SeeedDocument/RePhone_core_2G-Atmel32u4/img/New Microsoft PowerPoint 演示文稿.pptx

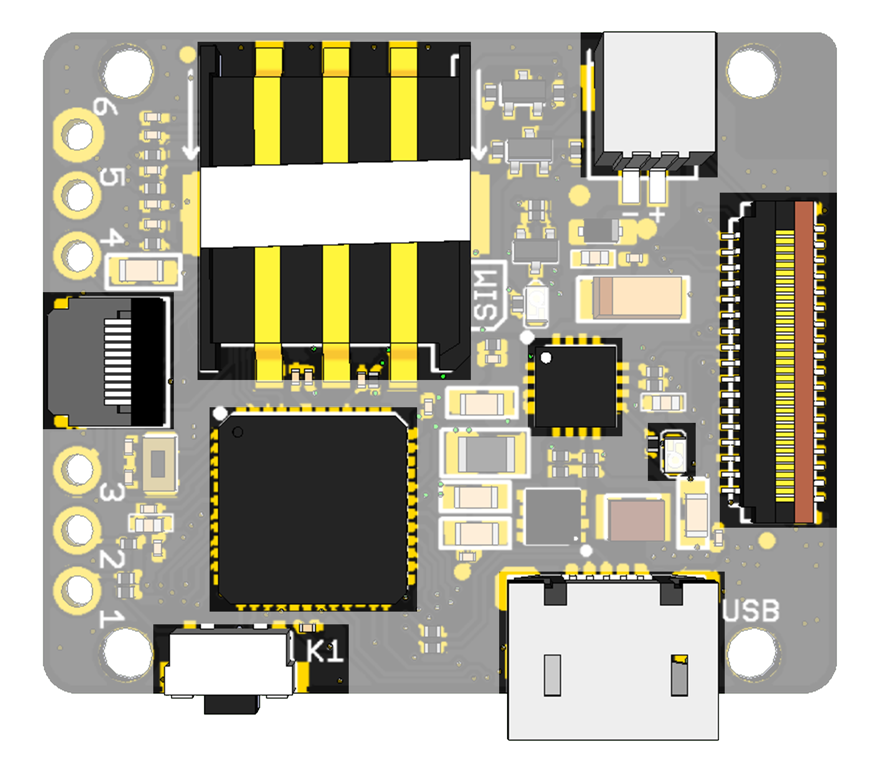
[picture p4: figure]

TOP

5

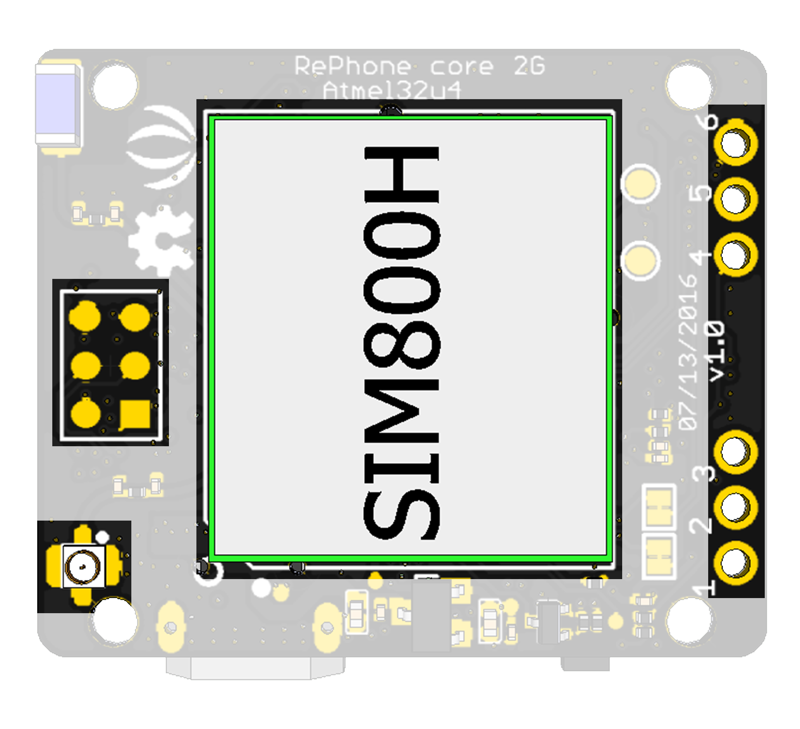
[picture p5: figure]

BOTTOM

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
## Slide 2

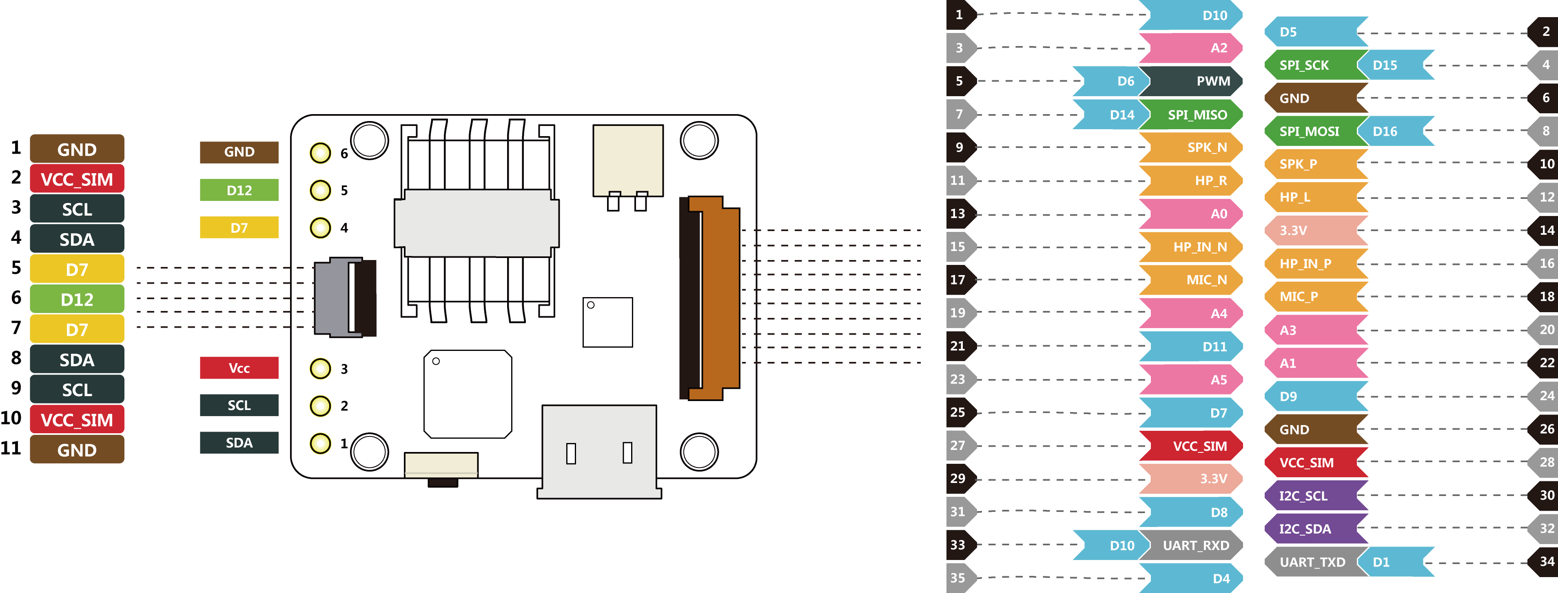
[picture p6: figure]

## Slide 3

Download AT Command
