SeeedDocument/RePhone_core_2G-Atmel32u4/img/arduino_ide.png

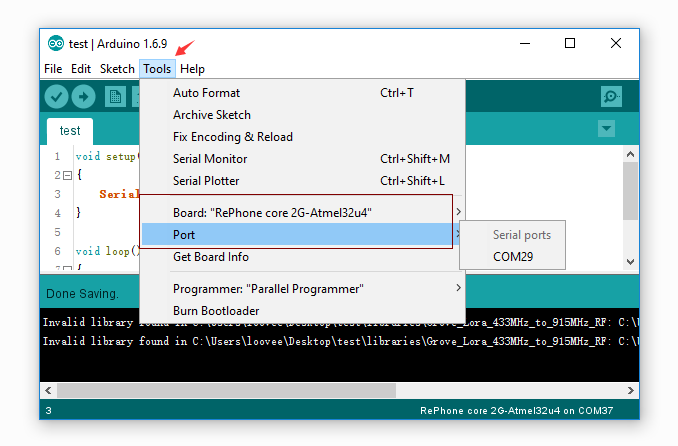
img/arduino_ide.png
