SeeedDocument/RePhone_core_2G-Atmel32u4/img/boards_manager.png

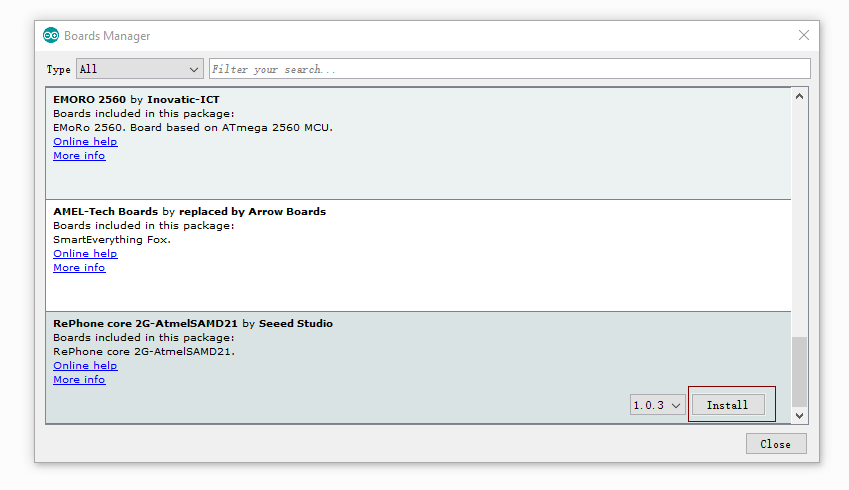
img/boards_manager.png
