SeeedDocument/RePhone_core_2G-Atmel32u4/img/cmd.png

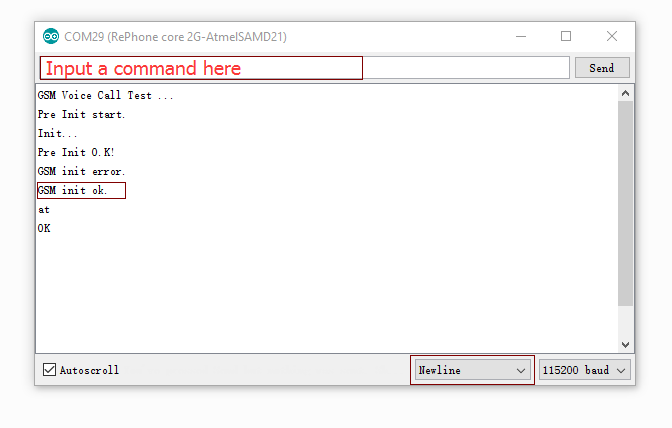
img/cmd.png
