SeeedDocument/RePhone_core_2G-Atmel32u4/img/cover.jpg

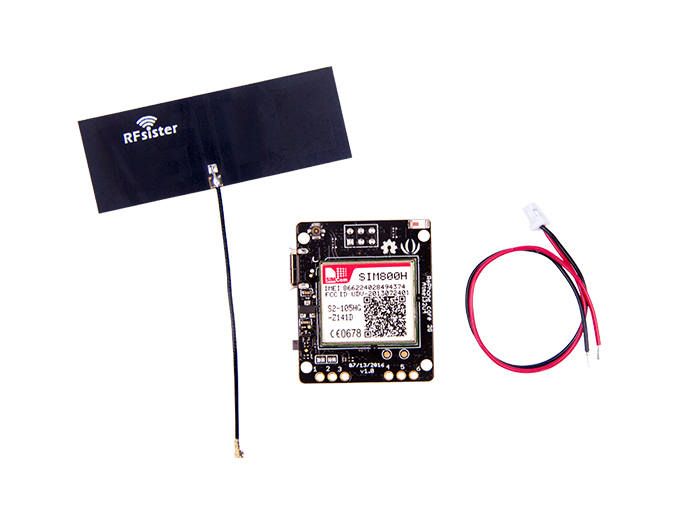
img/cover.jpg
