SeeedDocument/RePhone_core_2G-Atmel32u4/img/device_manager.png

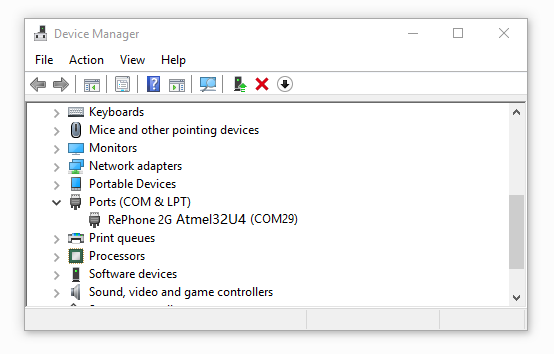
img/device_manager.png
