SeeedDocument/RePhone_core_2G-Atmel32u4/img/hello_world.png

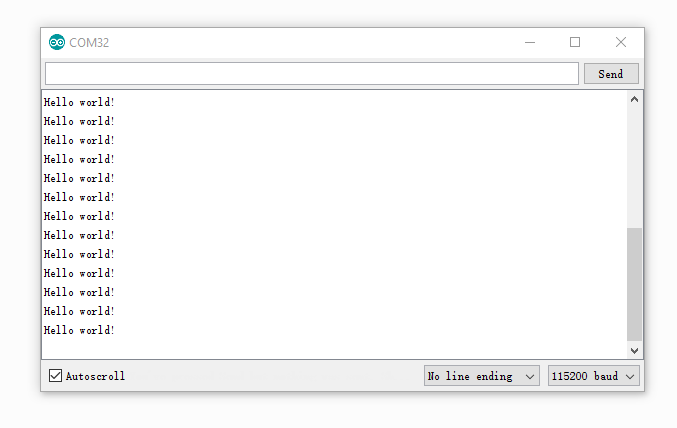
img/hello_world.png
