SeeedDocument/RePhone_core_2G-Atmel32u4/img/hw.png

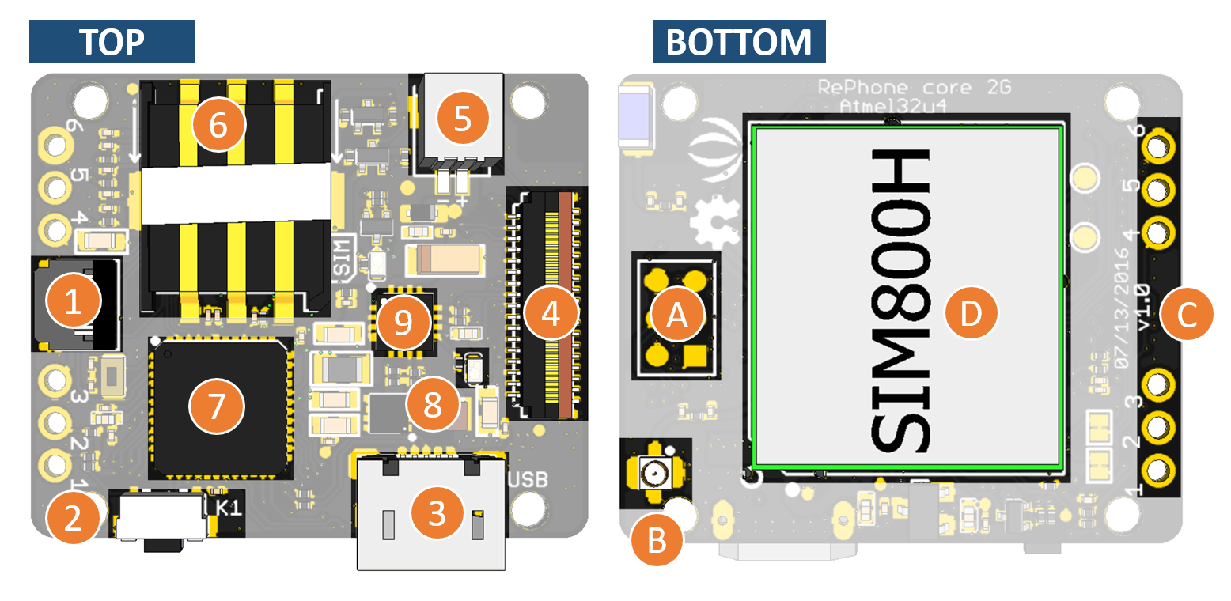
img/hw.png
