SeeedDocument/RePhone_core_2G-Atmel32u4/img/hw_bottom.png

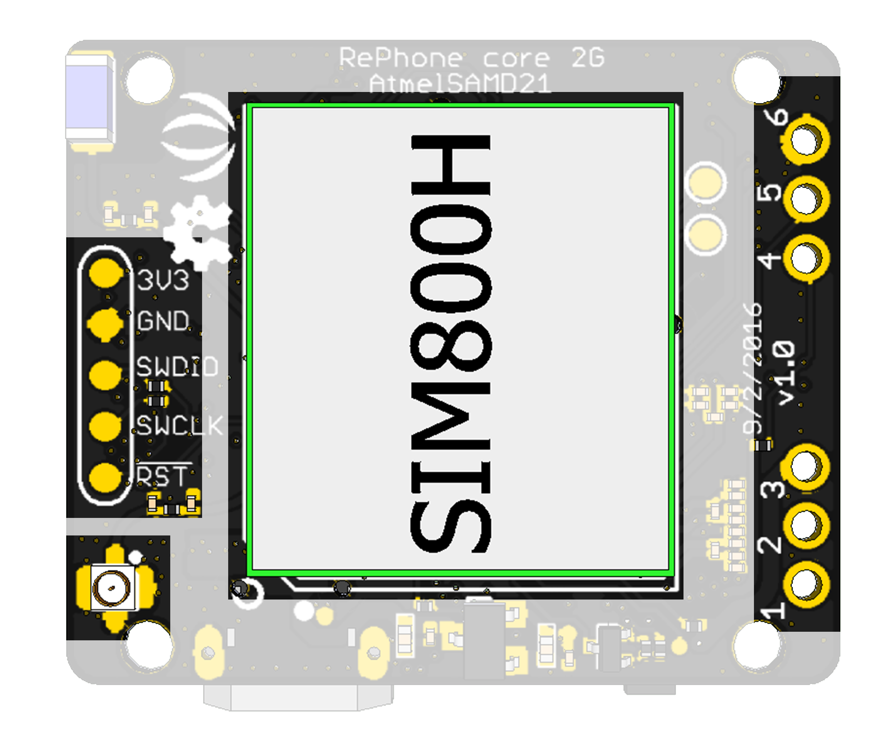
img/hw_bottom.png
