SeeedDocument/RePhone_core_2G-Atmel32u4/img/pinmap.png

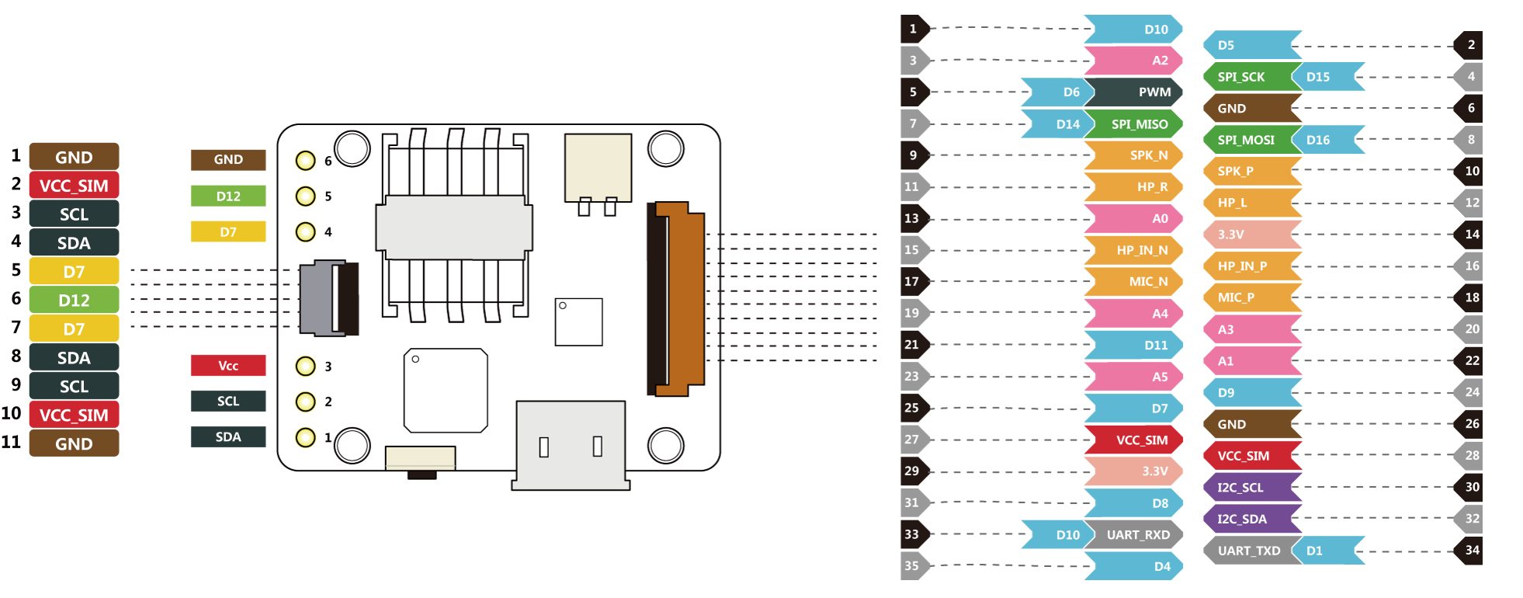
img/pinmap.png
