SeeedDocument/RePhone_core_2G-Atmel32u4/img/upload.png

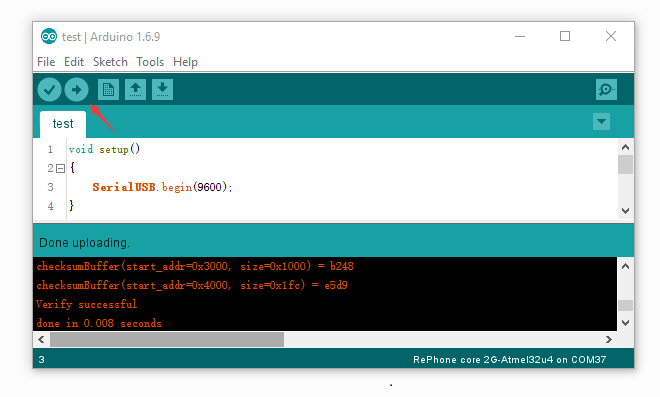
img/upload.png
