SeeedDocument/RePhone_core_2G-Atmel32u4/img/upload_done.png

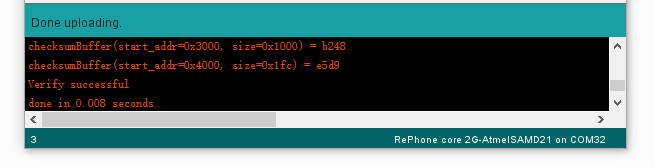
img/upload_done.png
