SeeedDocument/RePhone_core_2G-Atmel32u4/img/正面.png

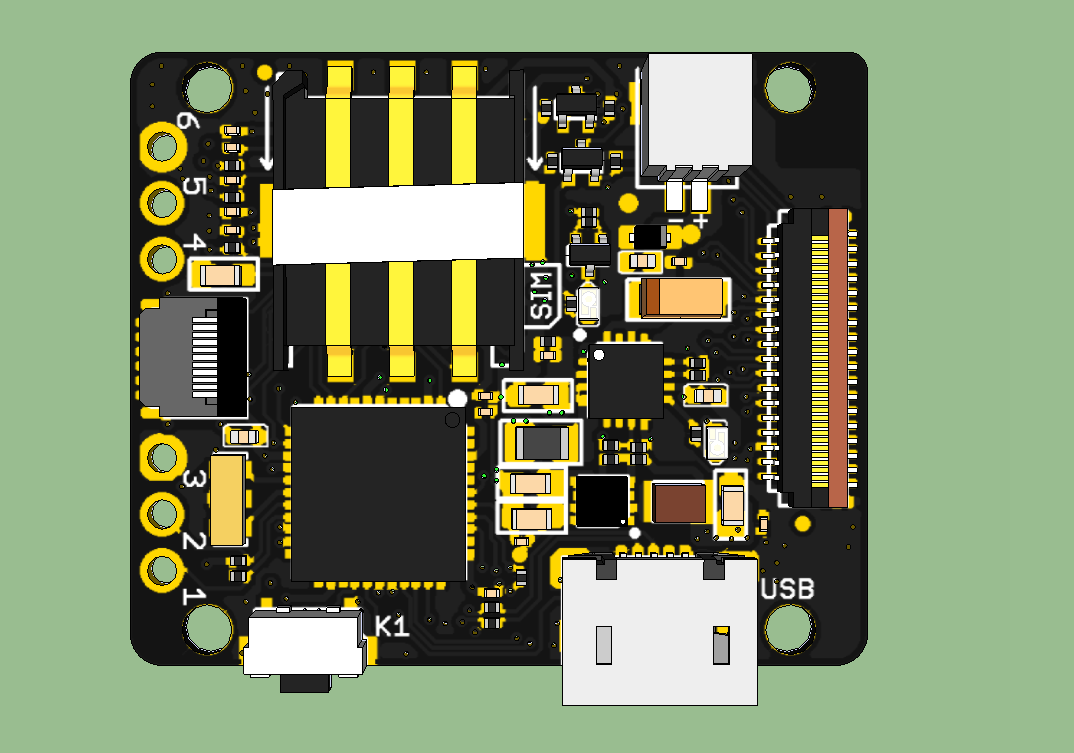
img/正面.png
