SeeedDocument/RePhone_core_2G-Atmel32u4/img/背面.png

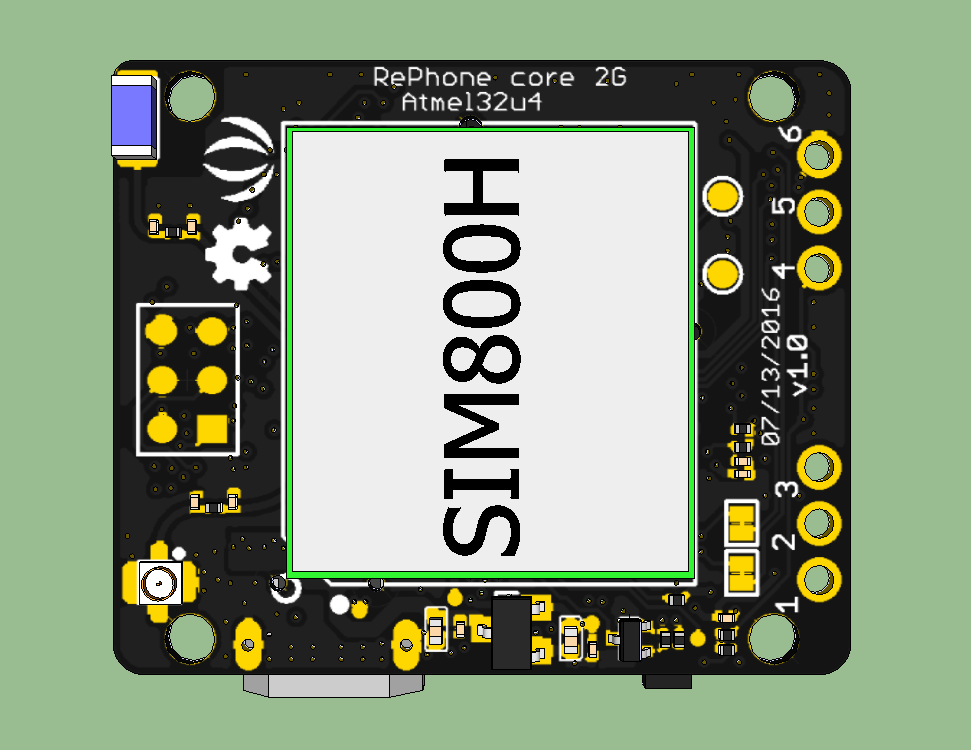
img/背面.png
