SeeedDocument/RePhone_core_2G-Atmel32u4/(list of files, cad)

Other CAD files:
img/RePhone core 2G-Atmel32u4 v1.0/RePhone core 2G-Atmel32u4 v1.0.skp
