SeeedDocument/RePhone_core_2G-Atmel32u4/res/pdf_sch_rephone_2g.pdf

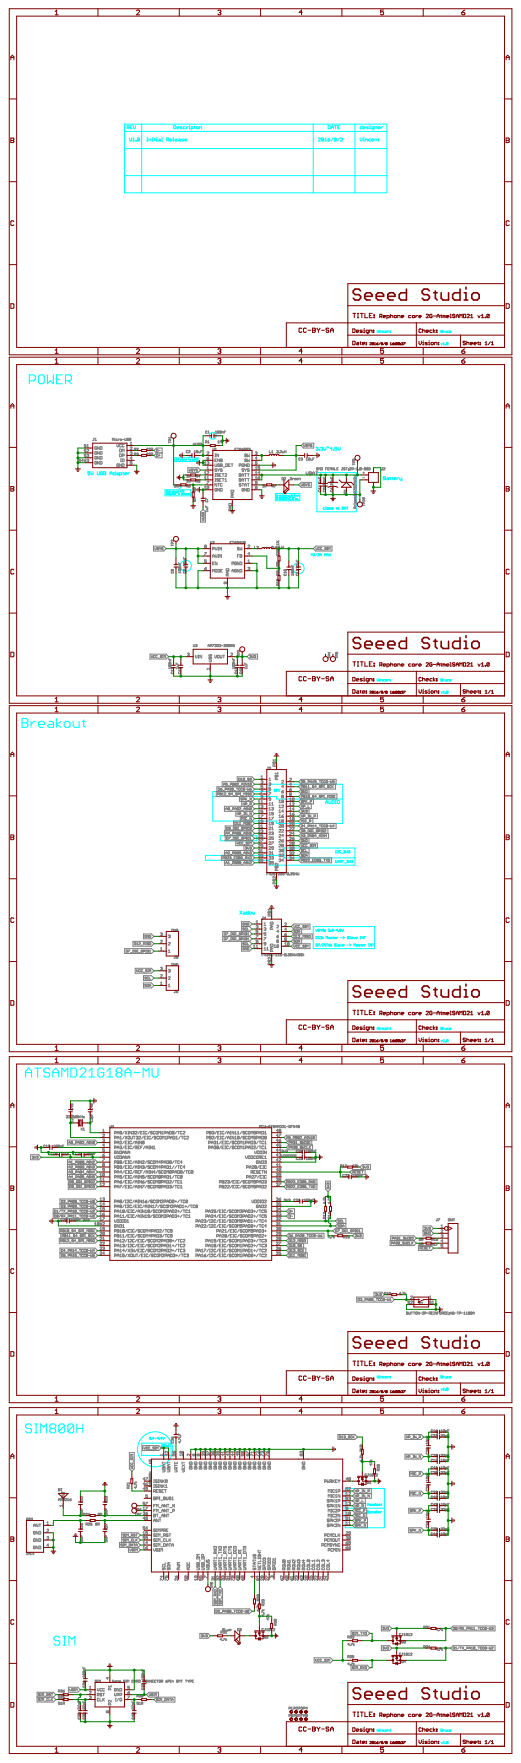
[picture p21: page 1]
