SeeedDocument/RePhone_core_2G-Atmel32u4/img/RePhone core 2G-Atmel32u4 v1.0/RePhone core 2G-Atmel32u4 v1.pdf

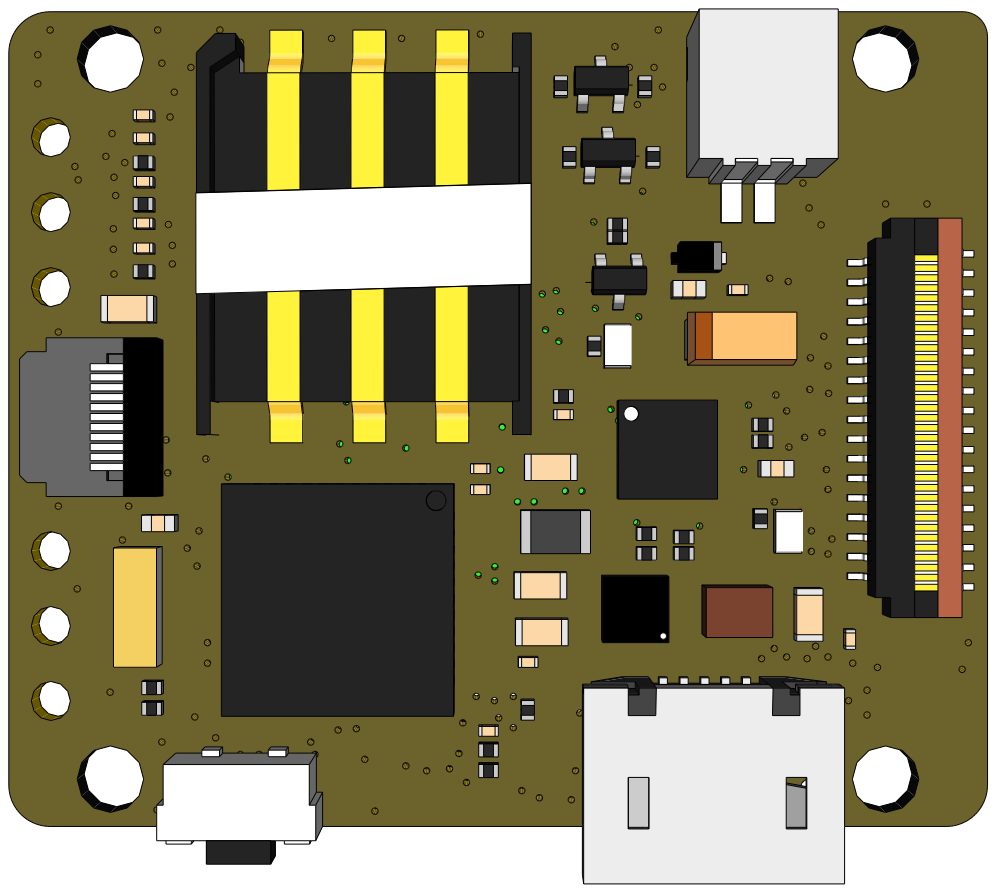
[picture p22: page 1]
