SeeedDocument/RePhone_core_2G-Atmel32u4/(commit log)

2016-12-01 add resources
    [Rephone core 2G-AtmelSAMD21 v1.0.brd, Rephone core 2G-AtmelSAMD21 v1.0.sch]
2016-12-27 add cover image
    [RePhone core 2G-Atmel32u4 v1.0.brd, RePhone core 2G-Atmel32u4 v1.0.sch, RePhone core 2G-Atmel32u4 v1.0.skp]
